OSU-Geomatics/OregonState_DLM/doc/ElectronicsPackageBillOfMaterials.xlsx

Number to Packages | 1 | <-ONLY EDIT THIS NUMBER
Part | Packages Per Unit | Unit Cost | Quantity | Total Cost | Link
Accelerometer | 0.25 | $9.95 | 4 | $39.80 | https://www.sparkfun.com/products/12756
Teensy 3.2 microcontroller | 0.50 | $19.95 | 2 | $39.90 | https://www.sparkfun.com/products/13736
micro-USB cable | 0.50 | $4.95 | 2 | $9.90 | https://www.sparkfun.com/products/10215
Ribbon Cable | 2.00 | $4.95 | 1 | $4.95 | https://www.sparkfun.com/products/10647
USB Hub | 1.00 | $6.99 | 1 | $6.99 | http://www.amazon.com/Sabrent-4-Port-Individual-Switches-HB-UMLS/dp/B00BWF5U0M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
10 Prototype Boards | 10.00 | $3.95 | 1 | $3.95 | http://www.amazon.com/Vktech-Prototype-Universal-Printed-Circuit/dp/B00CGV6TZG?s=aps
28 Pin Socket | 1.50 | $1.25 | 1 | $1.25 | https://www.adafruit.com/products/2206
6 Wire Assembly | 0.25 | $1.95 | 4 | $7.80 | https://www.sparkfun.com/products/9922
1/16" Heat Shrink (10ft) | 7.50 | $6.99 | 1 | $6.99 | https://www.amazon.com/Heat-Shrink-Tubing-10FT-Black/dp/B01BZDZE9W/ref=zg_bs_tab_pd_bsnr_1?th=1
Jumper Wires (optional) | 1.00 | $6.95 | 1 | $6.95 | https://www.sparkfun.com/products/124
Total |  |  |  | $128.48
Total Cost Per Package |  |  |  | $128.48
Part | Unit Cost | Quantity | Total Cost | Link
Accelerometer | $9.95 | 4 | $39.80 | https://www.sparkfun.com/products/12756
Teensy 3.2 microcontroller | $19.95 | 2 | $39.90 | https://www.sparkfun.com/products/13736
micro-USB cable | $4.95 | 2 | $9.90 | https://www.sparkfun.com/products/10215
Ribbon Cable | $4.95 | 1 | $4.95 | https://www.sparkfun.com/products/10647
USB Hub | $6.99 | 1 | $6.99 | http://www.amazon.com/Sabrent-4-Port-Individual-Switches-HB-UMLS/dp/B00BWF5U0M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
10 Prototype Boards | $3.95 | 1 | $3.95 | http://www.amazon.com/Vktech-Prototype-Universal-Printed-Circuit/dp/B00CGV6TZG?s=aps
28 Pin Socket | $1.25 | 1 | $1.25 | https://www.adafruit.com/products/2206
6 Wire Assembly | $1.95 | 4 | $7.80 | https://www.sparkfun.com/products/9922
1/16" Heat Shrink (10ft) | $6.99 | 1 | $6.99 | https://www.amazon.com/Heat-Shrink-Tubing-10FT-Black/dp/B01BZDZE9W/ref=zg_bs_tab_pd_bsnr_1?th=1
Jumper Wires (optional) | $6.95 | 1 | $6.95 | https://www.sparkfun.com/products/124
Total |  |  | $128.48
