OSU-Geomatics/OregonState_DLM/electronics/ProtoboardLayout.pdf

## PROTOBOARD: BOTTOM

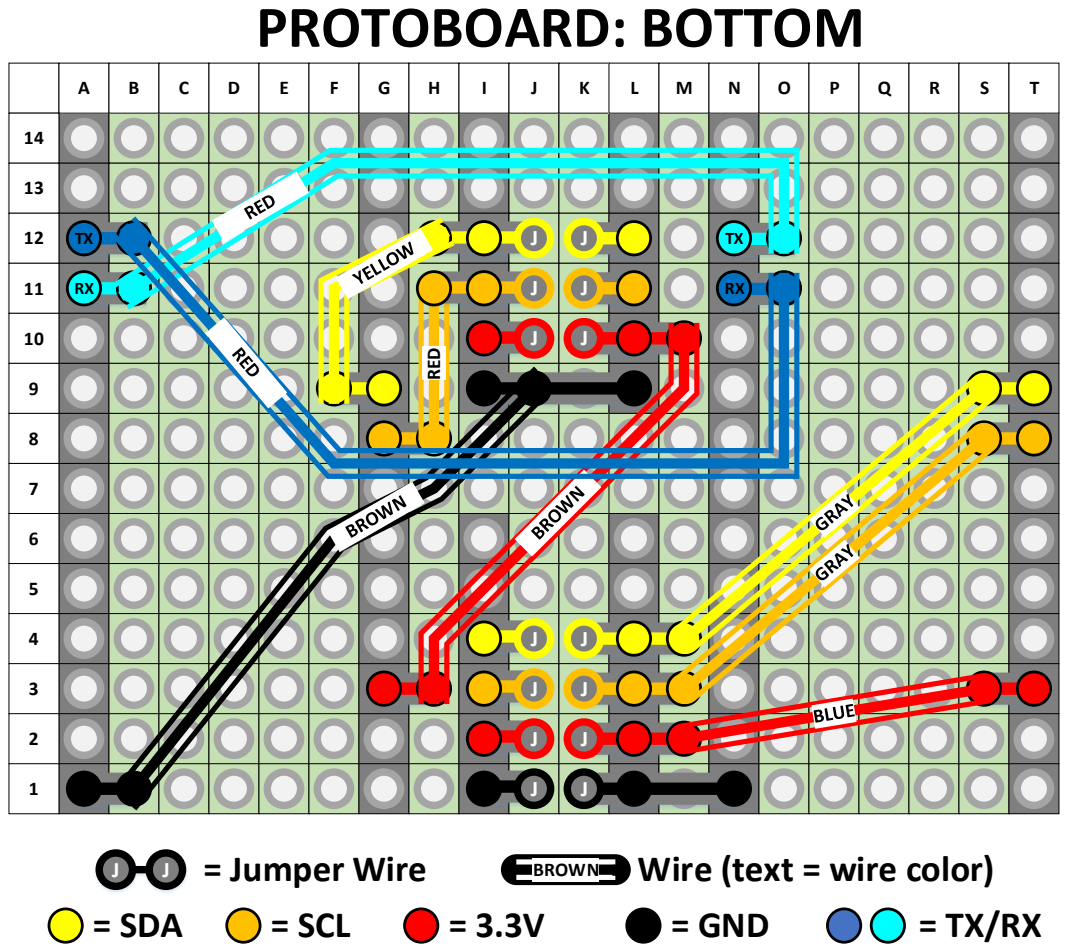
[picture p3: page 1]
T RED; = Jumper Wire; = Wire (text = wire color) BROWN; = SDA; = SCL; = GND

## PROTOBOARD: TOP

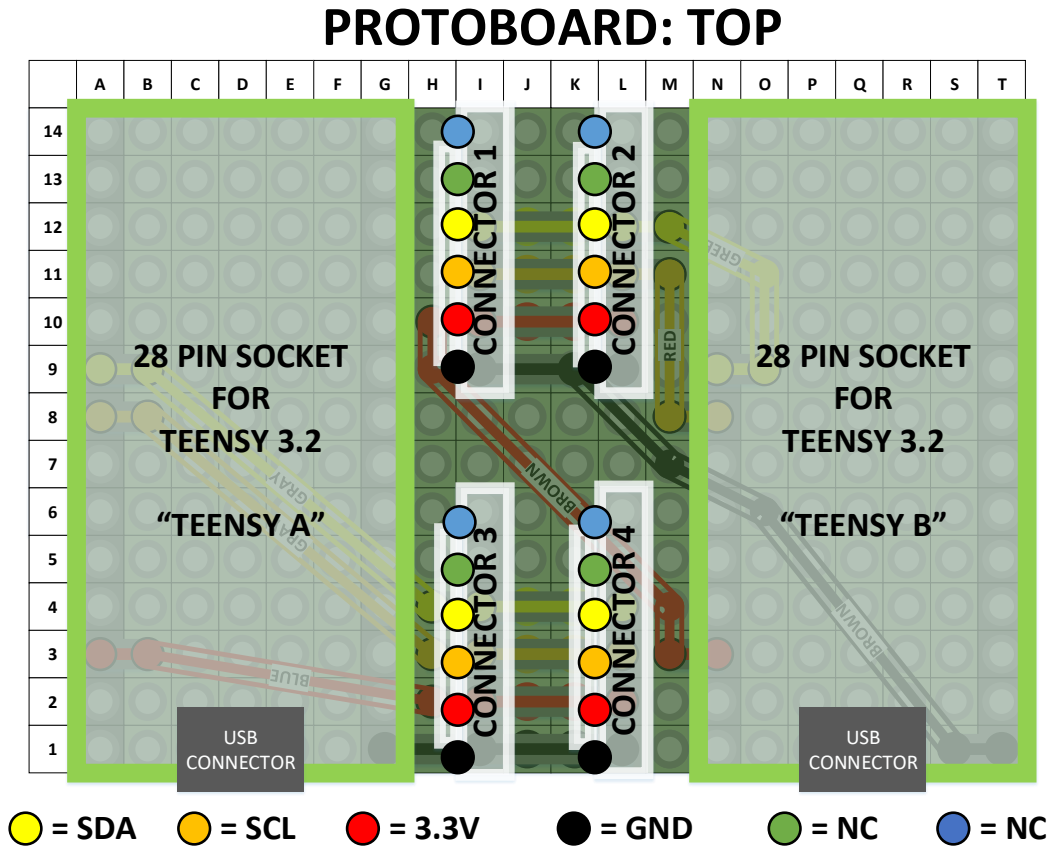
[picture p4: page 2]
RED; CONNECTOR 1; CONNECTOR 2; CONNECTOR 3; CONNECTOR 4; = SDA; = SCL; = GND

10
9 | | | 28 PIN SOCKET | | | | | | | | | | | | | | | | | | 28 PIN SOCKET

8 | | | | TEENSY 3.2 | FOR | | | | | | | | | | | | | | TEENSY 3.2 | | FOR

6 | | | TEENSY A | | | | | | | | | | | | | | TEENSY B

1 | | | | CONNECTOR | USB | | | | | | | | | | | | | | | | | CONNECTOR | USB
