OSU-Geomatics/OregonState_DLM/electronics/kicadfiles/schematic.pdf

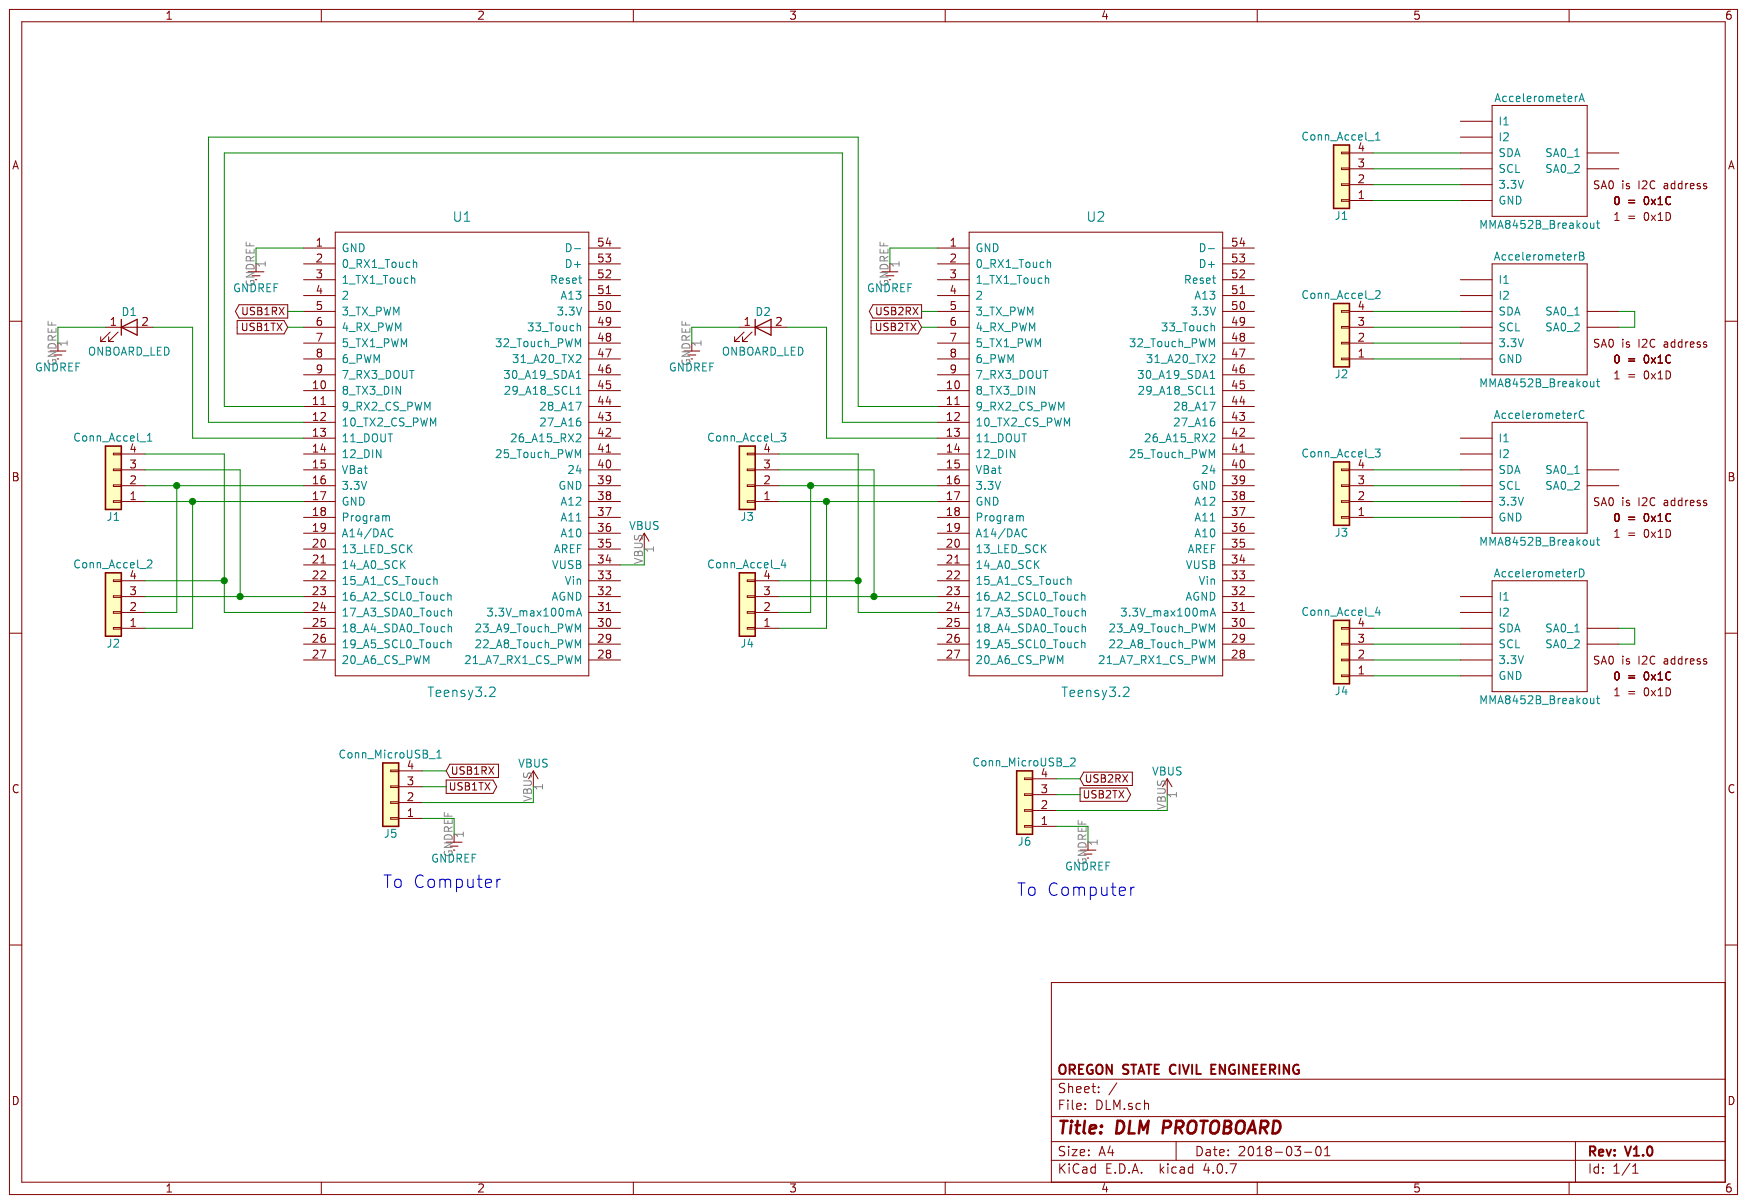
[picture p5: page 1]
