OSU-Geomatics/OregonState_DLM/electronics/kicadfiles/DLM.kicad_pcb

## KiCad design LED driver.sch

Schematic: LED driver.sch

Parts:
D1, D2, D3, D4, D5, D6, D7, D8, D9, D10, D11, D12, D13, D14, D15, D16: LED; LED_Rectangular_W3.9mm_H1.8mm_FlatTop
J2: CONN_02X10
Q1, Q2: 2N3904; TO-92_Molded_Narrow
R1: 4,7k; R_Axial_DIN0414_L11.9mm_D4.5mm_P5.08mm_Vertical
RN3, RN4, RN5, RN6: R_Network04; R_Array_SIP5
