OSU-Geomatics/OregonState_DLM/electronics/kicadfiles/DLM.kicad_pcb

## KiCad design bee-light-measurement-matrix.sch

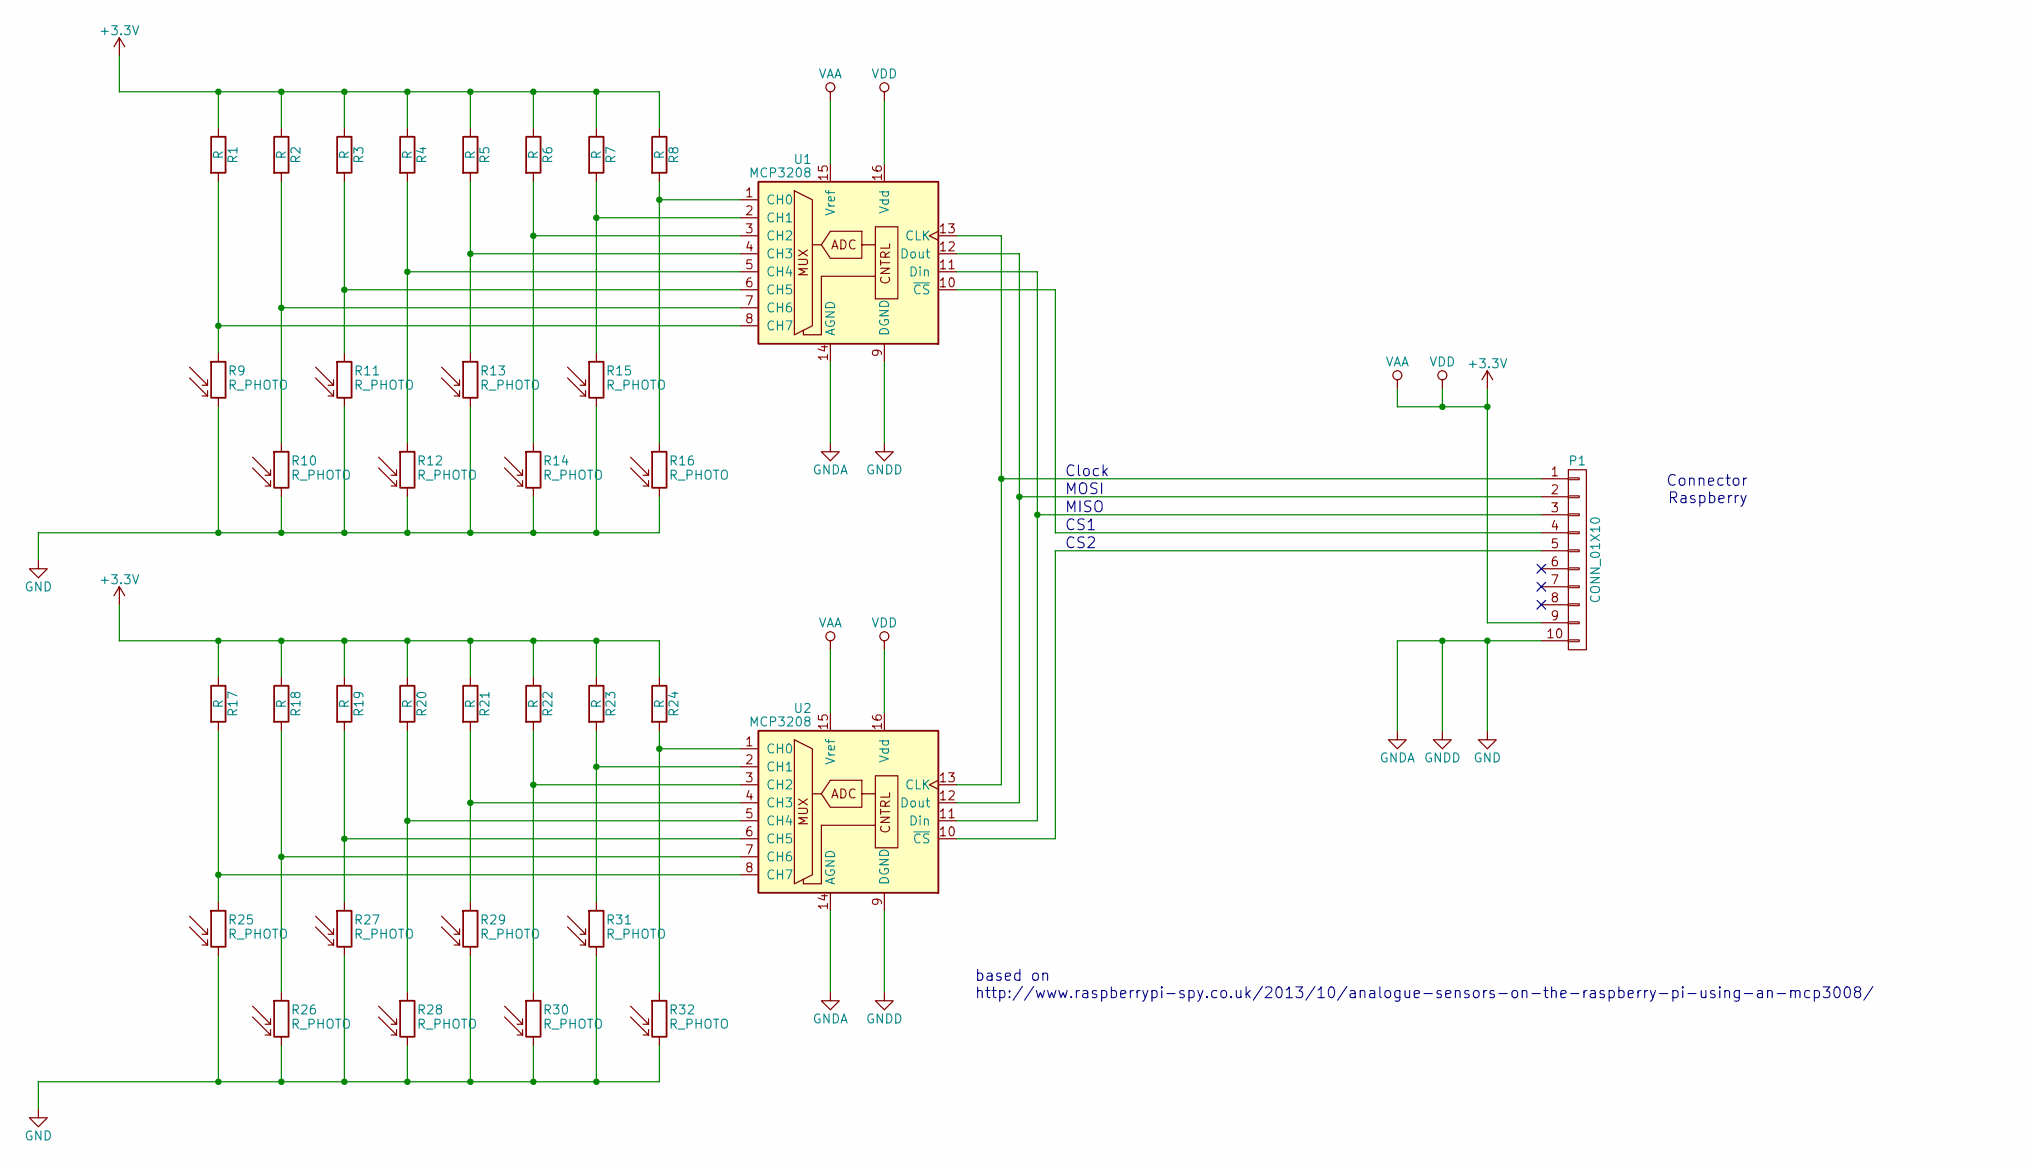
[picture p6: schematic bee-light-measurement-matrix.sch]

Parts:
P1: CONN_01X10
R1, R2, R3, R4, R5, R6, R7, R8, R17, R18, R19, R20, R21, R22, R23, R24: R
R9, R10, R11, R12, R13, R14, R15, R16, R25, R26, R27, R28, R29, R30, R31, R32: R_PHOTO
U1, U2: MCP3208

Connections:
+3.3V: P1.9, R1.1, R2.1, R3.1, R4.1, R5.1, R6.1, R7.1, R8.1, R17.1, R18.1, R19.1, R20.1, R21.1, R22.1, R23.1, R24.1, U1.15 (Vref), U1.16 (Vdd), U2.15 (Vref), U2.16 (Vdd)
GND: P1.10, R9.2, R10.2, R11.2, R12.2, R13.2, R14.2, R15.2, R16.2, R25.2, R26.2, R27.2, R28.2, R29.2, R30.2, R31.2, R32.2, U1.9 (DGND), U1.14 (AGND), U2.9 (DGND), U2.14 (AGND)
unnamed: P1.1, U1.13 (CLK), U2.13 (CLK)
unnamed: P1.2, U1.12 (Dout), U2.12 (Dout)
unnamed: P1.3, U1.11 (Din), U2.11 (Din)
unnamed: P1.4, U1.10 (~CS)
unnamed: P1.5, U2.10 (~CS)
unnamed: R1.2, R9.1, U1.8 (CH7)
unnamed: R2.2, R10.1, U1.7 (CH6)
unnamed: R3.2, R11.1, U1.6 (CH5)
unnamed: R4.2, R12.1, U1.5 (CH4)
unnamed: R5.2, R13.1, U1.4 (CH3)
unnamed: R6.2, R14.1, U1.3 (CH2)
unnamed: R7.2, R15.1, U1.2 (CH1)
unnamed: R8.2, R16.1, U1.1 (CH0)
unnamed: R17.2, R25.1, U2.8 (CH7)
unnamed: R18.2, R26.1, U2.7 (CH6)
unnamed: R19.2, R27.1, U2.6 (CH5)
unnamed: R20.2, R28.1, U2.5 (CH4)
unnamed: R21.2, R29.1, U2.4 (CH3)
unnamed: R22.2, R30.1, U2.3 (CH2)
unnamed: R23.2, R31.1, U2.2 (CH1)
unnamed: R24.2, R32.1, U2.1 (CH0)

Notes on the sheet:
CS2
CS1
MISO
MOSI
Clock
Connector Raspberry
based on http://www.raspberrypi-spy.co.uk/2013/10/analogue-sensors-on-the-raspberry-pi-using-an-mcp3008/
