OSU-Geomatics/OregonState_DLM/pythonGUI/testdata/tex/readme.tex

\documentclass{article}
\usepackage{Report1}

\begin{document}
	
	\insertSmallTitle
	{DLM Accelerometers}
	{Simulate DLM Data using `com0com' and Python}
	{Richard Slocum}
	{\today}
	
	\subsection*{Overview}
	
	Testing the GUI interface requires a data stream over two COM ports with the data from the Teensy microcontrollers.  Rather than always needing to be physically connected to the hardware, a virtual COM port is created which simulates the data stream from the sensors at the correct baud rate.  This allows the GUI to be tested and developed in a less cumbersome manner.  
	
	\subsection*{com0com installation}
	
	\subsection*{Setup com0com port settings}
	
	\subsection*{Log data with putty}
	
	\subsection*{Run Python to simulate data}
	
\end{document}
