OSU-Geomatics/OregonState_DLM/(threads)

Thread 1 (2016-08-31):

Optimize Teensy Acquisition/Transmission

hokiespurs, 2016-08-31:
The current methodology outputting data as a csv ascii file using the MMA8452Q Sparkfun library to communicate with two sensors is unable to keep up at the 800Hz data rate.  Two potential optimization methods should be considered.

## Serial Compression
Current output is a csv ascii formatted file

```
sensor ID, time(ms), X acceleration, Y acceleration, Z acceleration
```
example:
```
A,1289,-0.086,0.168,0.992
B,1292,-0.051,0.133,0.996
A,1293,-0.090,0.172,0.988
```
* synchronization is depicted as true if "C" and "D" are capital letters, and false if "c" and "d" are lower case

The size of each component is:
- SensorID: 2 bit
- Synchronization: 1 bit
- MMA8452Q Acceleration X: 12 bit
- MMA8452Q Acceleration Y: 12 bit
- MMA8452Q Acceleration Z: 12 bit
- Teensy Time: 32 bit

These could be compressed and written with Serial.write()

## Sensor Reading
The current method to read data from each accelerometer is to use the Sparkfun Library:
```arduino
#include <Wire.h> // Must include Wire library for I2C
#include <SparkFun_MMA8452Q.h> // Includes the SFE_MMA8452Q library
void setup() {
MMA8452Q accelA(0x1C);
}
void loop() {
  if (accelA.available())
  {
    accelA.read(); // updates accelA.x,y,z,cx,cy,cz
  }
}
```

This method handles all the register reading and bit shifting, but contains the unnecessary overhead of converting each 12 bit value to a float.  This could be replaced using a custom script to read the registers and send the data over serial in a compressed was more effificently.

## Serial Baud Rate
** Note that [the baud rate for the Teensy is always 12Mbps over Serial](https://forum.pjrc.com/threads/18852-Teensy-3-0-to-PC-communication-via-USB-serial-(-gt-256000-baud)) no matter what settings is set for
```arduino
Serial.begin()
```

Thread 2 (2016-08-31):

Enable 2-way communication with Teensy

hokiespurs, 2016-08-31:
Currently, the Teensy performs the following bootup:

1. initialize global variables
2. attempt to sync time to other teensy
3. apply constants to accelerometers for sample rate and max accelerations
4. begin streaming data

While this works for now, a more robust code would enable 2 way communication to the computer so that the user could:
- set sample rate
- set maximum accelerations
- begin and stop data transmission
- manually sync time between both Teensys
- enable/disable data transmission from individual accelerometers
  - this could allow for faster sample rate of individual accelerometers

This will enable the building of a more responsive GUI, and allow the user to experiment with different accelerometer settings

Thread 3 (2016-08-31):

Documentation

hokiespurs, 2016-08-31:
The following needs to be documented
- [ ] Current performance from the accelerometers (sample rate, noise floor, etc)
- [ ] Teensy Arduino Code
- [ ] Installation of Arduino code on Teensy
- [ ] com0com simulation
- [ ] electronics schematic and protoboard design
- [ ] overview of electronics system part selection
- [ ] DLMc and DLMg (command prompt and GUI) implementation
- [ ] assembly of accelerometers on DLM

hokiespurs, 2016-09-14:
## Python Packages
pip list
```
future (0.15.2)
numpy (1.11.1)
pefile (2016.3.28)
pip (8.1.2)
PyInstaller (3.2)
pypiwin32 (219)
pyqtgraph (0.9.10)
pyserial (3.1.1)
setuptools (26.1.1)
six (1.10.0)
wheel (0.29.0)
```

Thread 4 (2016-08-31):

Acquisition Wishlist/Idea Brainstorm

hokiespurs, 2016-08-31:
The acquisition scripts will be broken into:

1. DLMg.exe, an interactive GUI with real time plotting
2. DLMc.exe, a command line tool with arguments passed to it

## Wishlist for DLMg.exe (DLM GUI)
- [x] current sample rate of each accelerometer
- [x] enable/disable scrolling button
- [x] slider/spinbox for scrolling window length
- [x] user select colors for plotting/checkbox for turning plots on/off
- [x] status window with messages
- [x] save button with start/stop
- [x] optional fixed y limits
- [x] use classes to make code organized
- [ ] option to only plot points within limits of window
- [ ] tab for the plots (acceleration vs time, power vs frequency, time vs frequency (spectrogram))
- [ ] retain ability to function if one or more accelerometers are "turned off"

## Wishlist for DLMc.exe (DLM Command Line Tool)
- [x] argument 1: outputfilename
- [x] user type "q" to quit
- [x] just log data as fast as possible to filename

hokiespurs, 2016-09-07:
## DLMg.exe (DLM GUI) Proposed Layout
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

hokiespurs, 2016-09-13:
Added checked wishlist items to enhancement issue #5

Closed 2016-09-13.

Thread 5 (2016-09-13):

GUI enhancement

hokiespurs, 2016-09-13:
## DLMg enhancements
- [ ] option to only plot points within limits of window
  - plot fps slows as number of points grows
- [ ] tab for the more plots (acceleration vs time, power vs frequency, time vs frequency (spectrogram))
  - change plot widget to have tabs
- [ ] retain ability to function if one or more accelerometers are "turned off"
  - currently will not work (needs both com ports, scrolling window sizes use a max/min of all accelerometers)

hokiespurs, 2016-09-22:
added functionality to only plot what is within window

Thread 7 (2016-09-15):

Design and test Printed Circuit Board

hokiespurs, 2016-09-15:
Initial testing shows the protoboard layout is functional.

Designing and ordering PCBs would make the development of future boards take much less time.

Thread 8 (2016-09-22):

plot fails to update legend changes after "stop"

hokiespurs, 2016-09-22:
plot doesn't update after the "stop" button has been checked and legend entries are modified.

add a for loop to connect the change color and checkbox state change to the updatePlot function.

Closed 2016-09-22.

Thread 9 (2016-09-22):

plot fps decay

hokiespurs, 2016-09-22:
the plot update rate drops after a minute or two of data acquisition, despite only plotting data in the current window.  Where is the bottleneck?

- appending the lists?
- searching through a long list to figure out where the correct indices are?
- other??

Closed 2016-09-22.
