OSU-Geomatics/OregonState_DLM/(commit log)

2016-08-28 add arduino scripts
2016-08-31 update Teensy Code to write data faster
2016-09-07 fix some DLMc pep8
    [COMLogger.py, main.py]
2016-09-09 change DLMc final print message
    - "success" was printed even if it failed
    [main.py]
2016-09-10 add interwidget interactions to enable/disable buttons
2016-09-12 add data reader thread
2016-09-14 fix valid filename bug
    [acceldata.py]
2016-09-22 remove debug print statement
2016-09-22 fix index out of range error
    - simplified code to only look at max from current accelerometer
    - closes #10
2016-09-28 add excel BOM
    [ElectronicsPackageBillOfMaterials.xlsx]
2018-03-13 add kicad schematic
    [DLM.kicad_pcb, DLM.sch]
